Sammed101/AquaGuard_Motherboard-Arduino-Based/Images/Complete Wiring after Mods.jpeg

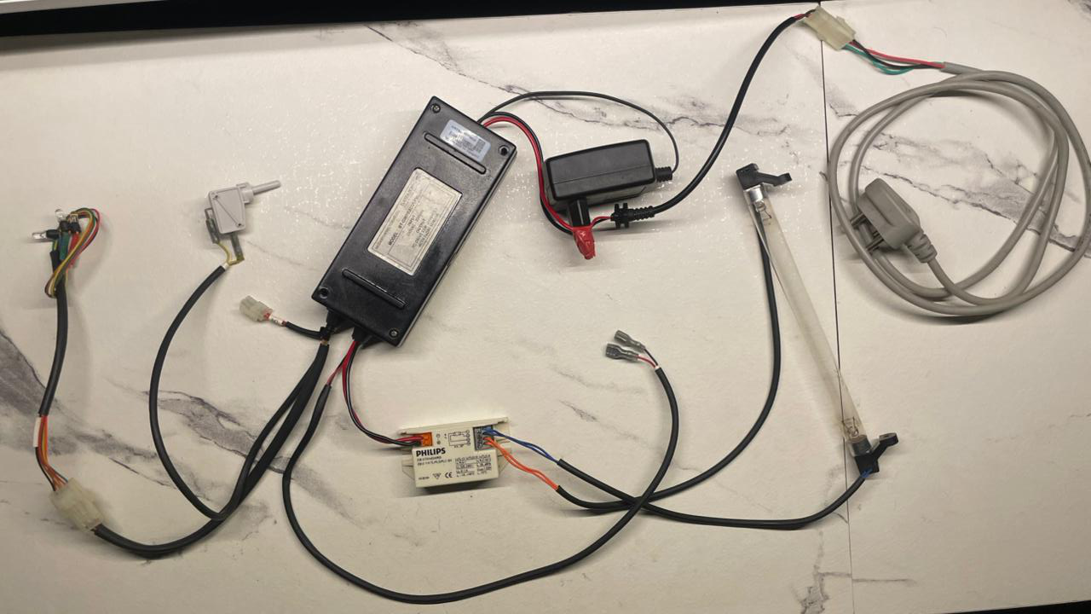
Images/Complete Wiring after Mods.jpeg
