Sammed101/AquaGuard_Motherboard-Arduino-Based/(commit log)

2026-04-06 Add .gitignore for Arduino and IDE files
2026-04-11 Invert UV relay control logic
    [AquaGuard_Mother_Board_Replica_Code.ino]
2026-04-11 Rename Water Flow Diagram & Wiring Diagram.jpeg to Images/Water Flow Diagram & Wiring Diagram.jpeg
2026-04-11 Revise state machine and hardware section in README
    Updated state flow diagram and hardware requirements in README.
2026-04-21 Fix formatting for Pin Map section in README
